BenjDC/ar4-chessplayer/essai.png

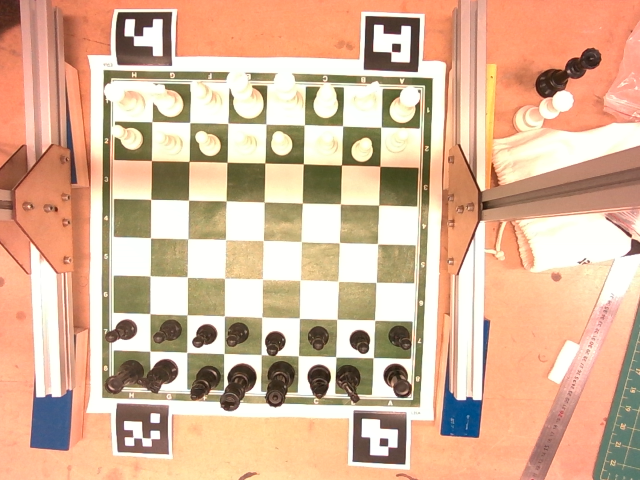
essai.png
