BenjDC/ar4-chessplayer/essai2.png

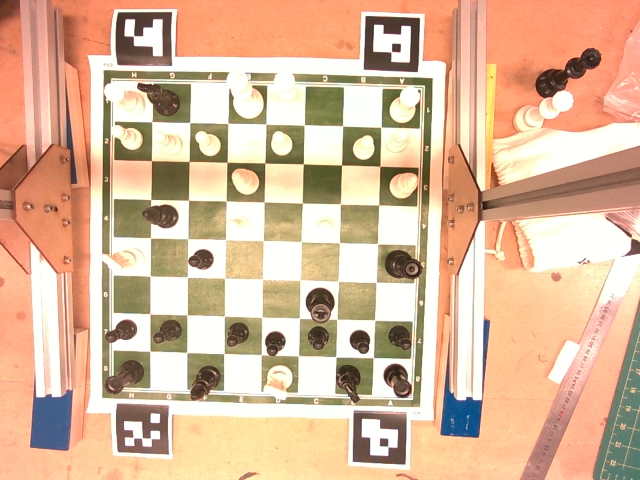
essai2.png
