BenjDC/ar4-chessplayer/mecanique/onshape/RESUME.md

# Export Onshape – Caisson

*Généré automatiquement le 2026-11-13 21:26 UTC par `tools/onshape_export.py`. Ne pas modifier à la main.*

Document : https://cad.onshape.com/documents/e18b653be252676ae3b8c36c/w/db663cb86067f77f2d0621fb

## Onglets

| Onglet | Type |
|---|---|
| guide angle | PARTSTUDIO |
| caisson | ASSEMBLY |
| Variable Studio 1 | VARIABLESTUDIO |
| BOM : caisson | BILLOFMATERIALS |

## Détail

### Part Studio « guide angle »

| Pièce | Matériau | Masse (g) | Volume (cm³) | Centre de gravité (mm) |
|---|---|---|---|---|
| Part 1 | — |  | 13.16 | 0.0, 0.0, 0.0 |

Arbre des features (8) :

- Esquisse 1 (`newSketch`)
- Extruder 1 (`extrude`) — thickness1 = 5 mm, thickness2 = 0 mm, thickness = 5 mm, depth = 5 mm, offsetDistance = 25 mm, startOffsetDistance = 25 mm, draftAngle = 3 deg, secondDirectionDepth = 25 mm, secondDirectionOffsetDistance = 25 mm, secondDirectionDraftAngle = 3 deg
- Esquisse 2 (`newSketch`)
- Extruder 2 (`extrude`) — thickness1 = 5 mm, thickness2 = 0 mm, thickness = 5 mm, depth = 10 mm, offsetDistance = 25 mm, startOffsetDistance = 25 mm, draftAngle = 3 deg, secondDirectionDepth = 25 mm, secondDirectionOffsetDistance = 25 mm, secondDirectionDraftAngle = 3 deg
- Extruder 3 (`extrude`) — thickness1 = 5 mm, thickness2 = 0 mm, thickness = 5 mm, depth = 5 mm, offsetDistance = 25 mm, startOffsetDistance = 15 mm, draftAngle = 3 deg, secondDirectionDepth = 25 mm, secondDirectionOffsetDistance = 25 mm, secondDirectionDraftAngle = 3 deg
- Congé 1 (`fillet`) — radius = 10 mm, nonCircularRadius = 5 mm, width = 5 mm, rho = 0.5, magnitude = 0.5, otherRadius = 5 mm, startPartialOffset = 5 mm, partialFirstEdgeTotalParameter = 0.01, endPartialOffset = 5 mm, partialSecondEdgeTotalParameter = 0.99
- Congé 2 (`fillet`) — radius = 2 mm, nonCircularRadius = 5 mm, width = 5 mm, rho = 0.5, magnitude = 0.5, otherRadius = 5 mm, startPartialOffset = 5 mm, partialFirstEdgeTotalParameter = 0.01, endPartialOffset = 5 mm, partialSecondEdgeTotalParameter = 0.99
- Congé 3 (`fillet`) — radius = 5 mm, nonCircularRadius = 5 mm, width = 5 mm, rho = 0.5, magnitude = 0.5, otherRadius = 5 mm, startPartialOffset = 5 mm, partialFirstEdgeTotalParameter = 0.01, endPartialOffset = 5 mm, partialSecondEdgeTotalParameter = 0.99

### Assemblage « caisson »

Instances de premier niveau (36) :

| Instance | Type | Position (mm) | Source externe |
|---|---|---|---|
| 100113 <1> | Part | -76.7, 180.0, 828.9 | oui |
| 100113 <2> | Part | -76.7, -430.0, 828.9 | oui |
| 100113 <3> | Part | 33.3, -425.0, 223.9 | oui |
| 100113 <4> | Part | 33.3, 180.0, 828.9 | oui |
| 100078 <1> | Part | 28.3, -430.0, 223.9 | oui |
| 100078 <2> | Part | -71.7, 180.0, 833.9 | oui |
| 100078 <3> | Part | -71.7, 180.0, 223.9 | oui |
| 100078 <4> | Part | -71.7, -430.0, 833.9 | oui |
| 100113 <5> | Part | 33.3, 175.0, 833.9 | oui |
| 100113 <6> | Part | -76.7, 175.0, 223.9 | oui |
| 100113 <7> | Part | 33.3, -430.0, 828.9 | oui |
| 100113 <8> | Part | -76.7, -425.0, 833.9 | oui |
| Part 1 <1> | Part | 33.3, 180.0, 223.9 | oui |
| Part 1 <2> | Part | -76.7, 180.0, 223.9 | oui |
| Part 1 <3> | Part | 33.3, 180.0, 833.9 | oui |
| Part 1 <4> | Part | -76.7, -430.0, 223.9 | oui |
| Part 1 <5> | Part | 33.3, -430.0, 223.9 | oui |
| Part 1 <6> | Part | 33.3, -430.0, 833.9 | oui |
| Part 1 <7> | Part | -76.7, 180.0, 833.9 | oui |
| Part 1 <8> | Part | -76.7, -430.0, 833.9 | oui |
| 100078 <5> | Part | -71.7, -430.0, 528.9 | oui |
| 100078 <6> | Part | -71.7, 180.0, 528.9 | oui |
| 100113 <9> | Part | -56.7, 175.0, 833.9 | oui |
| Corps <1> | Part | -54.9, -425.0, 826.7 | oui |
| Corps <3> | Part | -56.7, -116.9, 233.9 | oui |
| Corps <4> | Part | -56.7, -116.9, 823.9 | oui |
| Part 1 <9> | Part | -59.2, -131.4, 237.9 | oui |
| Part 1 <10> | Part | -59.2, -131.4, 819.9 | oui |
| 100113 <11> | Part | -36.7, -131.4, 228.8 | oui |
| Corps <5> | Part | -29.5, -133.2, 228.8 | oui |
| Corps <6> | Part | -26.7, -131.4, 446.0 | oui |
| Corps <2> | Part | -54.9, 175.0, 231.0 | oui |
| 100113 <10> | Part | -56.7, -425.0, 223.9 | oui |
| Part 1 <12> | Part | -47.7, 154.0, 554.9 | oui |
| Part 1 <11> | Part | -47.7, 154.0, 502.9 | oui |
| Part 1 <13> | Part | -51.7, 175.0, 228.9 |  |

Contraintes (56) :

- Fixe 1 (`FASTENED`)
- Fixe 2 (`FASTENED`)
- Fixe 3 (`FASTENED`)
- Fixe 4 (`FASTENED`)
- Fixe 5 (`FASTENED`)
- Fixe 6 (`FASTENED`)
- Fixe 7 (`FASTENED`)
- Fixe 8 (`FASTENED`)
- Fixe 9 (`FASTENED`)
- Fixe 10 (`FASTENED`)
- Fixe 11 (`FASTENED`)
- Fixe 12 (`FASTENED`)
- Fixe 13 (`FASTENED`)
- Fixe 14 (`FASTENED`)
- Fixe 15 (`FASTENED`)
- Fixe 16 (`FASTENED`)
- Fixe 17 (`FASTENED`)
- Fixe 18 (`FASTENED`)
- Fixe 19 (`FASTENED`)
- Fixe 20 (`FASTENED`)
- Fixe 21 (`FASTENED`)
- Fixe 25 (`FASTENED`)
- Fixe 26 (`FASTENED`)
- Glissière 2 (`SLIDER`)
- Fixe 27 (`FASTENED`)
- Fixe 28 (`FASTENED`)
- Fixe 29 (`FASTENED`)
- Glissière 3 (`SLIDER`)
- Planaire 1 (`PLANAR`)
- Planaire 2 (`PLANAR`)
- Planaire 3 (`PLANAR`)
- Planaire 4 (`PLANAR`)
- Planaire 5 (`PLANAR`)
- Planaire 6 (`PLANAR`)
- Planaire 7 (`PLANAR`)
- Planaire 8 (`PLANAR`)
- Planaire 9 (`PLANAR`)
- Planaire 10 (`PLANAR`)
- Planaire 11 (`PLANAR`)
- Hauteur Rails (`PLANAR`)
- Planaire 13 (`PLANAR`)
- Planaire 14 (`PLANAR`)
- Planaire 16 (`PLANAR`)
- Planaire 17 (`PLANAR`)
- Planaire 12 (`PLANAR`)
- Planaire 15 (`PLANAR`)
- Planaire 18 (`PLANAR`)
- Planaire 19 (`PLANAR`)
- Planaire 20 (`PLANAR`)
- Planaire 21 (`PLANAR`)
- Planaire 22 (`PLANAR`)
- Planaire 23 (`PLANAR`)
- Planaire 24 (`PLANAR`)
- Planaire 27 (`PLANAR`)
- Planaire 25 (`PLANAR`)
- Planaire 26 (`PLANAR`)

Nomenclature : 9 lignes, voir `assemblies/caisson/bom.csv`

---
Appels API utilisés pour cet export : 7
