BenjDC/ar4-chessplayer/docs/decisions/009-pieces-attirables-par-aimant.md

# 009 – Rendre les pièces attirables par l'aimant

- **Statut** : ouverte (urgente : conditionne le choix de l'électro-aimant et le test du jalon 2)
- **Exigences liées** : EX-10, EX-11, EX-30

## Contexte
Les pièces Damier Opéra sont lestées au plomb, or le plomb n'est pas ferromagnétique : l'électro-aimant ne les attire pas.

## Options à étudier
1. **Rondelle d'acier collée sous chaque pièce** : simple et bon marché, aucune attraction entre pièces voisines. La force dépend de l'épaisseur et de l'entrefer.
2. **Petit aimant néodyme sous chaque pièce** : prise plus forte et plus franche. Mais les pièces s'attirent ou se repoussent entre elles, et l'aimant permanent reste attiré par le noyau de l'électro-aimant hors tension (magnétisme résiduel).
3. **Remplacer le lest** : propre, mais demande de démonter les pièces.

## Lien avec la détection du coup
Des aimants néodyme rendraient possible la détection par capteurs à effet Hall, avec la couleur donnée par la polarité (voir 012). C'est un argument en faveur de l'option 2, à peser contre l'attraction entre pièces voisines.

## À trancher
Par le test du jalon 2 : entrefer réel (plexiglas, feutrine, épaisseur de l'échiquier vinyle), force minimale pour faire glisser une pièce, et absence d'effet sur les cases voisines à 50 mm.
