BenjDC/ar4-chessplayer/equerre_rail.FCStd

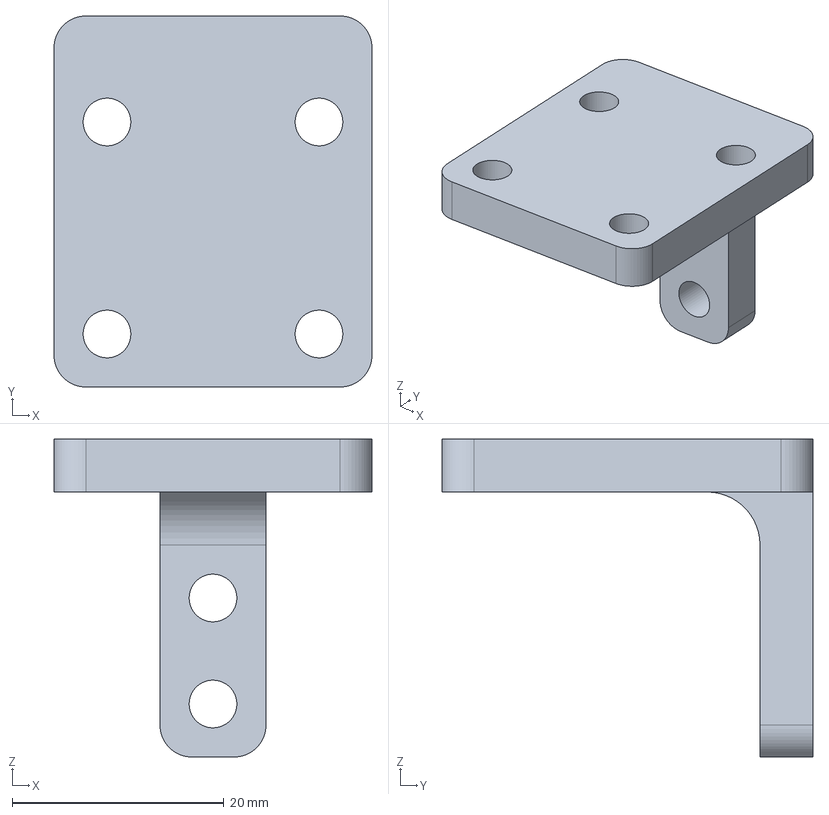
[picture p3: CAD file, 2026-02-19]
equerre_rail.FCStd
30.0 x 35.0 x 30.0 mm
