BenjDC/ar4-chessplayer/mecanique/pieces/makerbeam_corner.FCStd

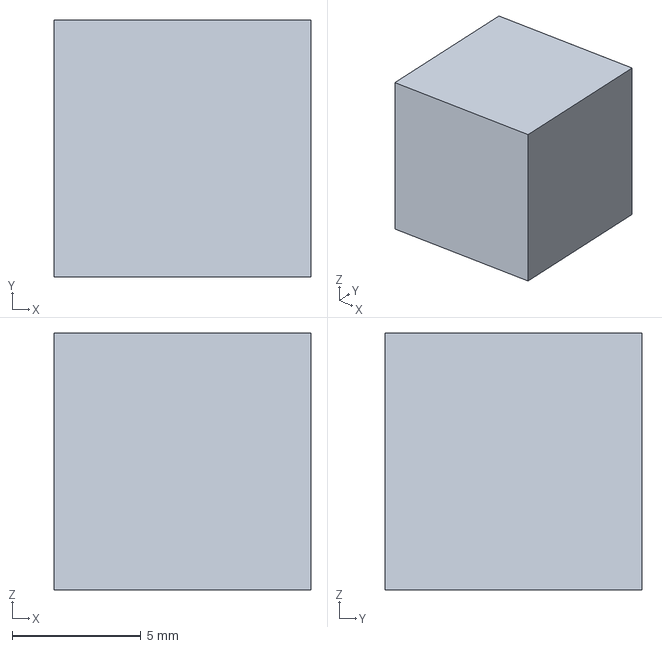
[picture p4: CAD file, 2026-04-03]
mecanique/pieces/makerbeam_corner.FCStd
10.0 x 10.0 x 10.0 mm
