BenjDC/ar4-chessplayer/mecanique/pieces/rail.FCStd

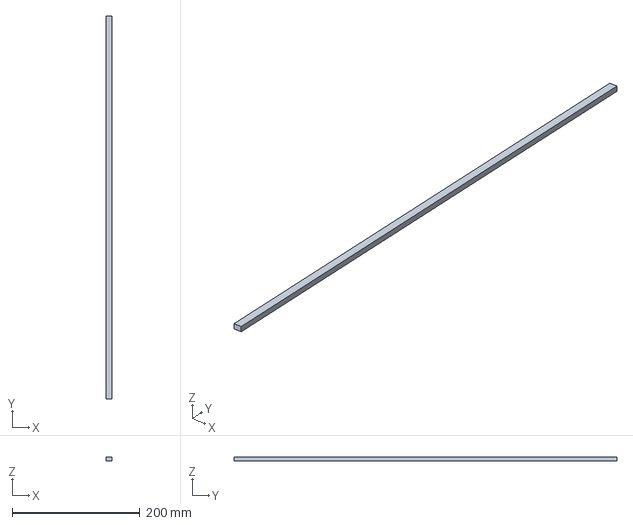
[picture p5: CAD file, 2026-04-03]
mecanique/pieces/rail.FCStd
9.00 x 600.0 x 6.00 mm
