BenjDC/ar4-chessplayer/mecanique/pieces/Chariot.FCStd

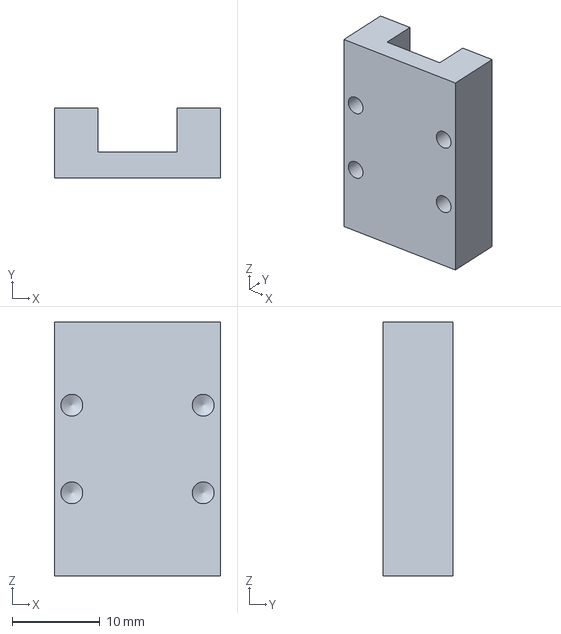
[picture p6: CAD file, 2026-04-03]
mecanique/pieces/Chariot.FCStd
19.0 x 8.00 x 29.0 mm
