BenjDC/ar4-chessplayer/mecanique/pieces/makerbeam_100.stp

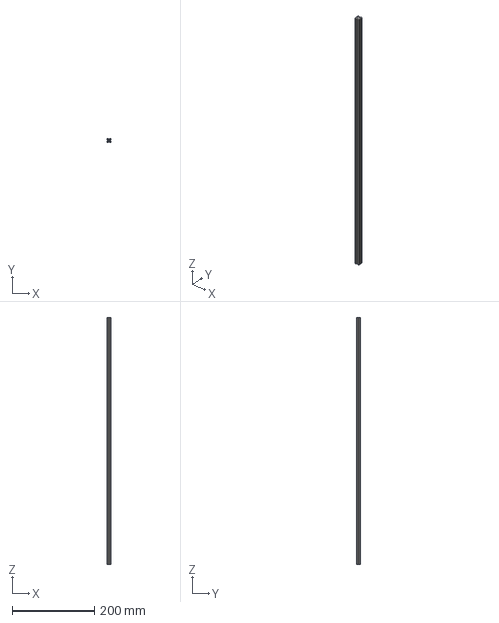
[picture p7: CAD file, 2026-02-20]
mecanique/pieces/makerbeam_100.stp
10.0 x 10.0 x 600.0 mm
