BenjDC/ar4-chessplayer/mecanique/pieces/makerbeam_600.stp

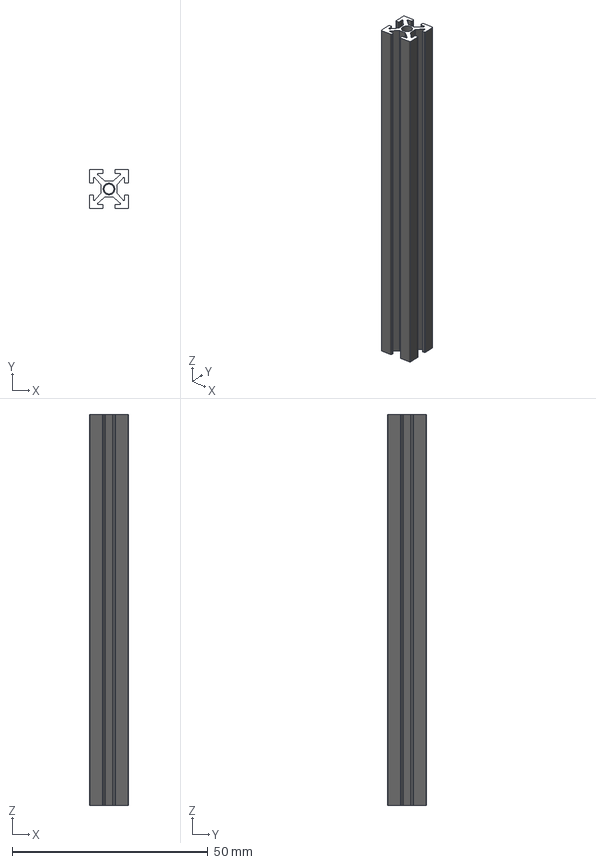
[picture p8: CAD file, 2026-02-20]
mecanique/pieces/makerbeam_600.stp
10.0 x 10.0 x 100.0 mm
