BenjDC/ar4-chessplayer/(list of files, cad)

Other CAD files:
mecanique/Joint_rail.FCStd
mecanique/caisson.FCStd
mecanique/pieces/makerbeam_100.FCStd
mecanique/pieces/makerbeam_600.FCStd
