BenjDC/ar4-chessplayer/(commit log)

2025-11-08 test de recherche des tags aruco
2025-11-09 Correction de bugs, galère sur la détection de mouvement
    [chessplayer.py]
2025-12-03 ajout assemblage cases
2025-12-03 Corrections locales et gitignore du dataset
    [chessplayer.py]
2025-12-04 Mises à jour. affichage reste à corriger et modèle à tester
    [chessplayer.py]
2025-12-05 corrections pour reconnaissance de coup
    [chessplayer.py]
2025-12-07 fixed code for display
    [chessplayer.py]
2025-12-07 Corrections locales (image et parametre inutile)
    [chessplayer.py]
2026-02-19 Add files via upload
    freecad equerre
    [equerre_rail.FCStd]
2026-02-20 fichiers mécan FreeCad
    [caisson.FCStd, makerbeam_100.FCStd, makerbeam_100.stp, makerbeam_600.FCStd, makerbeam_600.stp, makerbeam_corner.FCStd]
2026-02-22 mecanique update
    [caisson.FCStd, makerbeam_100.FCStd]
2026-03-23 Mise à jour méca
    [caisson.FCStd, makerbeam_corner.FCStd]
2026-04-03 update méca
    [Chariot.FCStd, caisson.FCStd, makerbeam_100.FCStd, makerbeam_600.FCStd, makerbeam_corner.FCStd, rail.FCStd]
2026-11-13 Export Onshape en lecture seule via GitHub Actions
    Script tools/onshape_export.py (onglets, pièces, masses, features,
    assemblages, nomenclature, STEP en option) et workflow manuel qui
    dépose le résultat dans mecanique/onshape/.
    Claude-Session: https://claude.ai/code/session_0131Bamsc4qN7CrYxBm3Eu1R
2026-11-13 Workflow Onshape : noms des secrets ONSHAPE_API_*, actions à jour (Node 24)
    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
